vladimir1211/TFG_Volodymyr_Bratasiuk/TMC6140_LA/imagenes/2.png

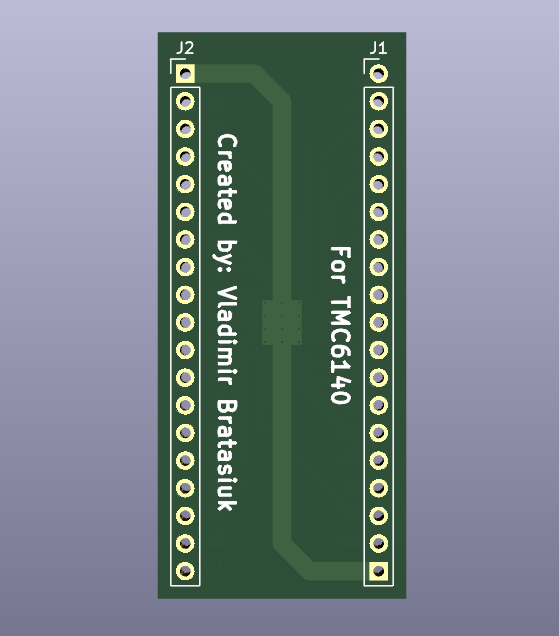
TMC6140_LA/imagenes/2.png
