vladimir1211/TFG_Volodymyr_Bratasiuk/README.md

# TFG_Volodymyr_Bratasiuk
Este repositorio contiene diseños de las PCBs generados para mi TFG durante la segunda mitad del 2022.
