vladimir1211/TFG_Volodymyr_Bratasiuk/BLDC_driver/imagenes/1.png

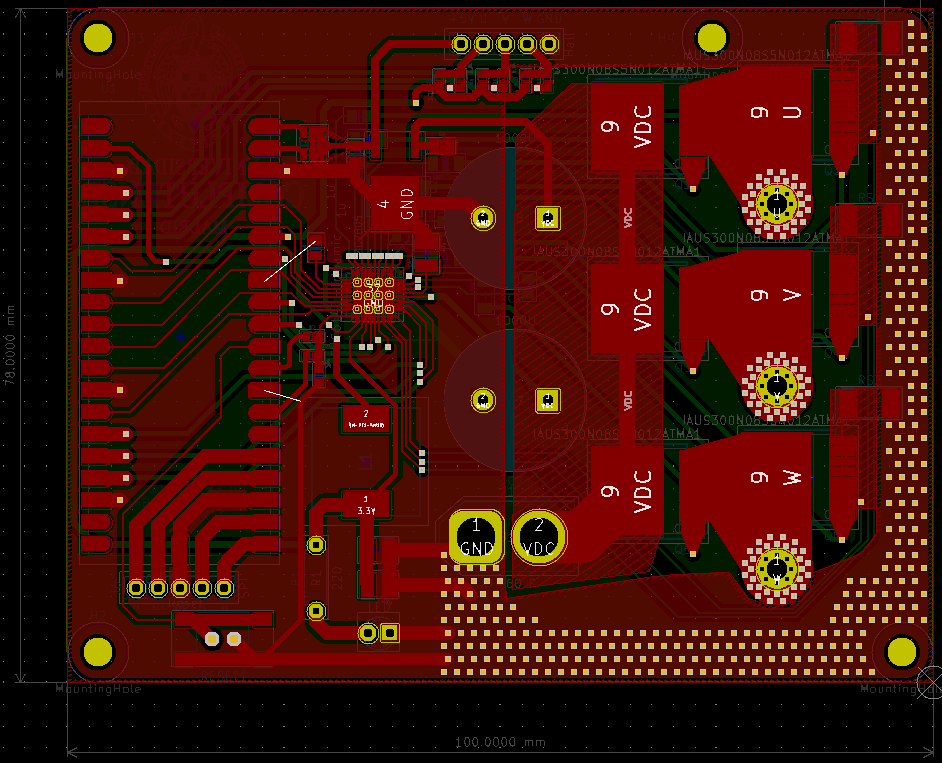
BLDC_driver/imagenes/1.png
