vladimir1211/TFG_Volodymyr_Bratasiuk/BLDC_driver/imagenes/3.png

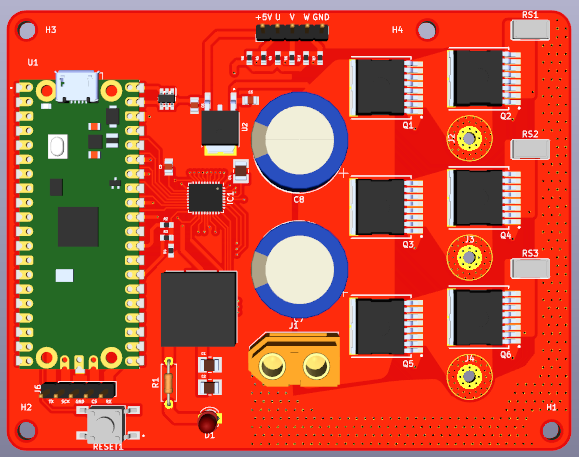
BLDC_driver/imagenes/3.png
