vladimir1211/TFG_Volodymyr_Bratasiuk/BLDC_driver/imagenes/5.jpg

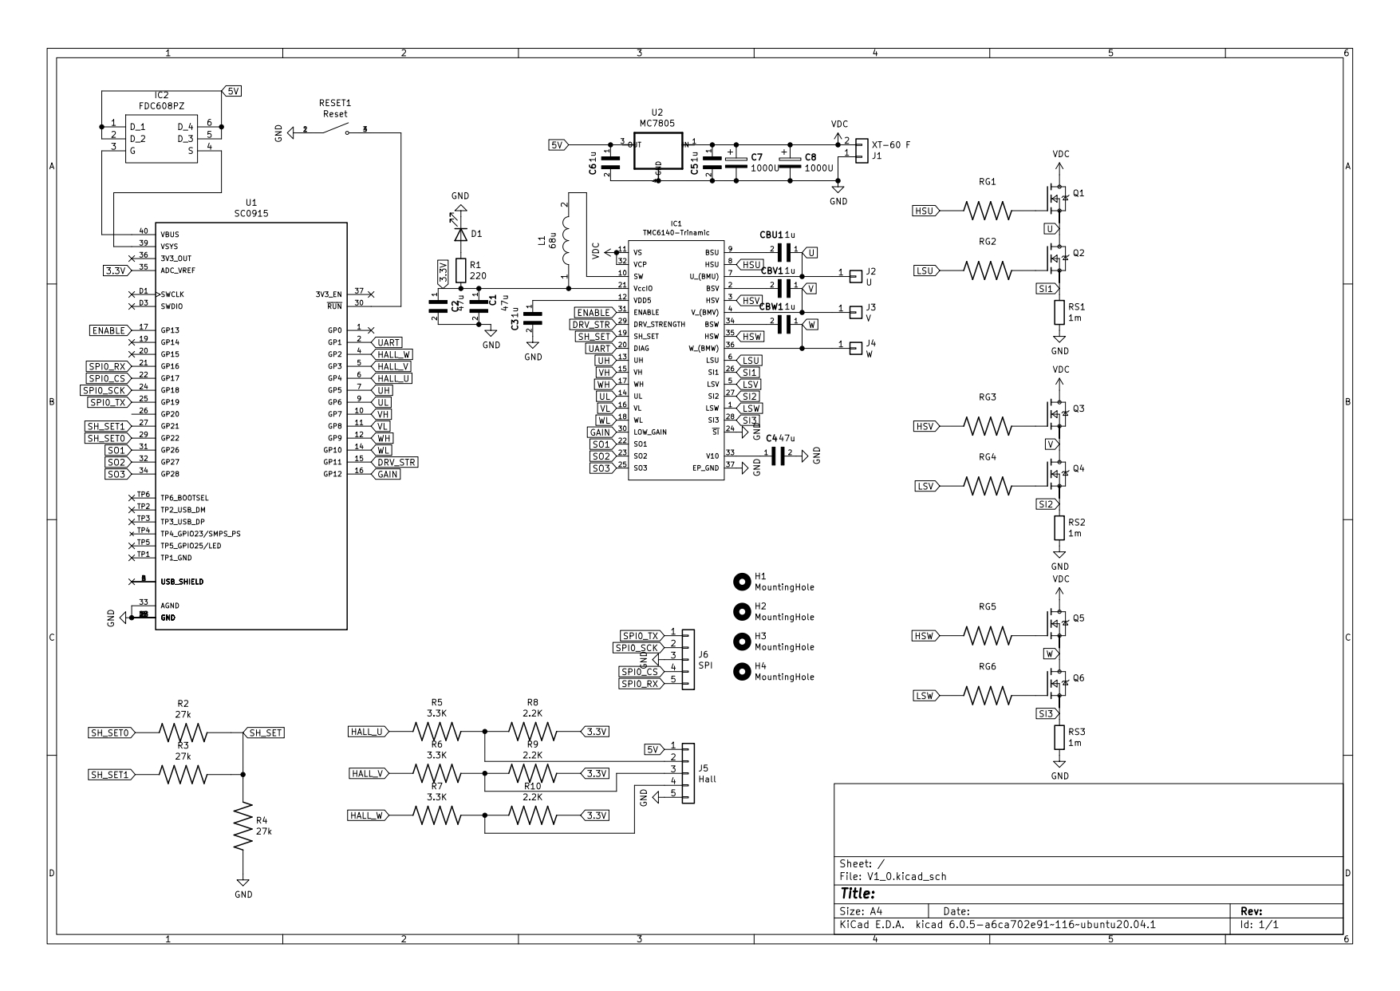
BLDC_driver/imagenes/5.jpg
