vladimir1211/TFG_Volodymyr_Bratasiuk/Sistema_central/imagenes/1.png

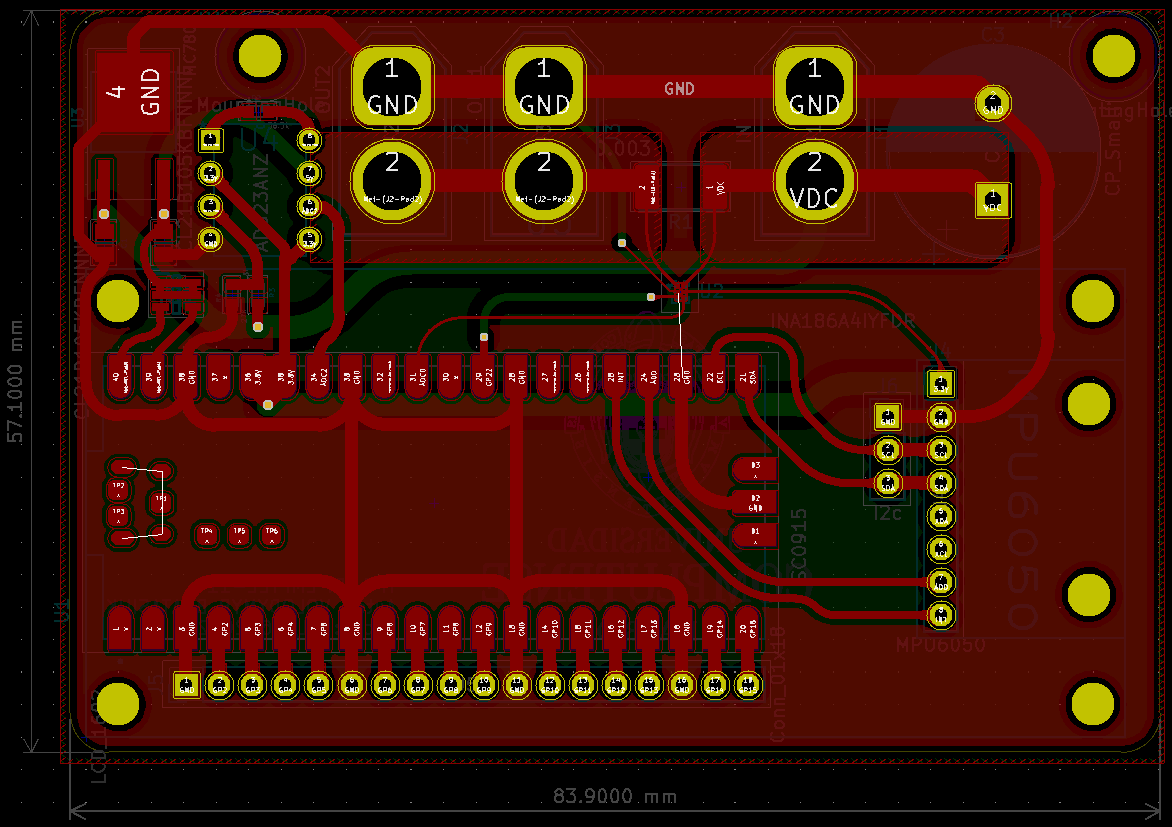
Sistema_central/imagenes/1.png
