vladimir1211/TFG_Volodymyr_Bratasiuk/Sistema_central/imagenes/4.png

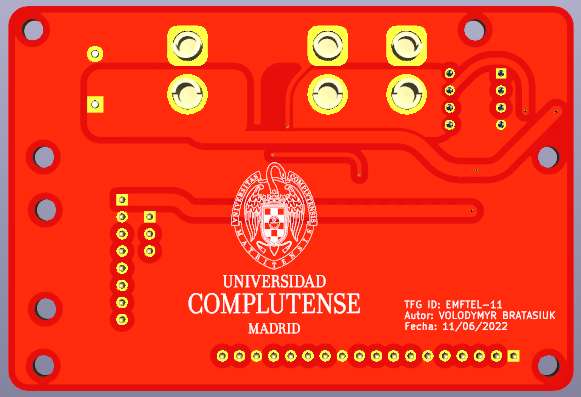
Sistema_central/imagenes/4.png
