vladimir1211/TFG_Volodymyr_Bratasiuk/Sistema_central/imagenes/5.jpg

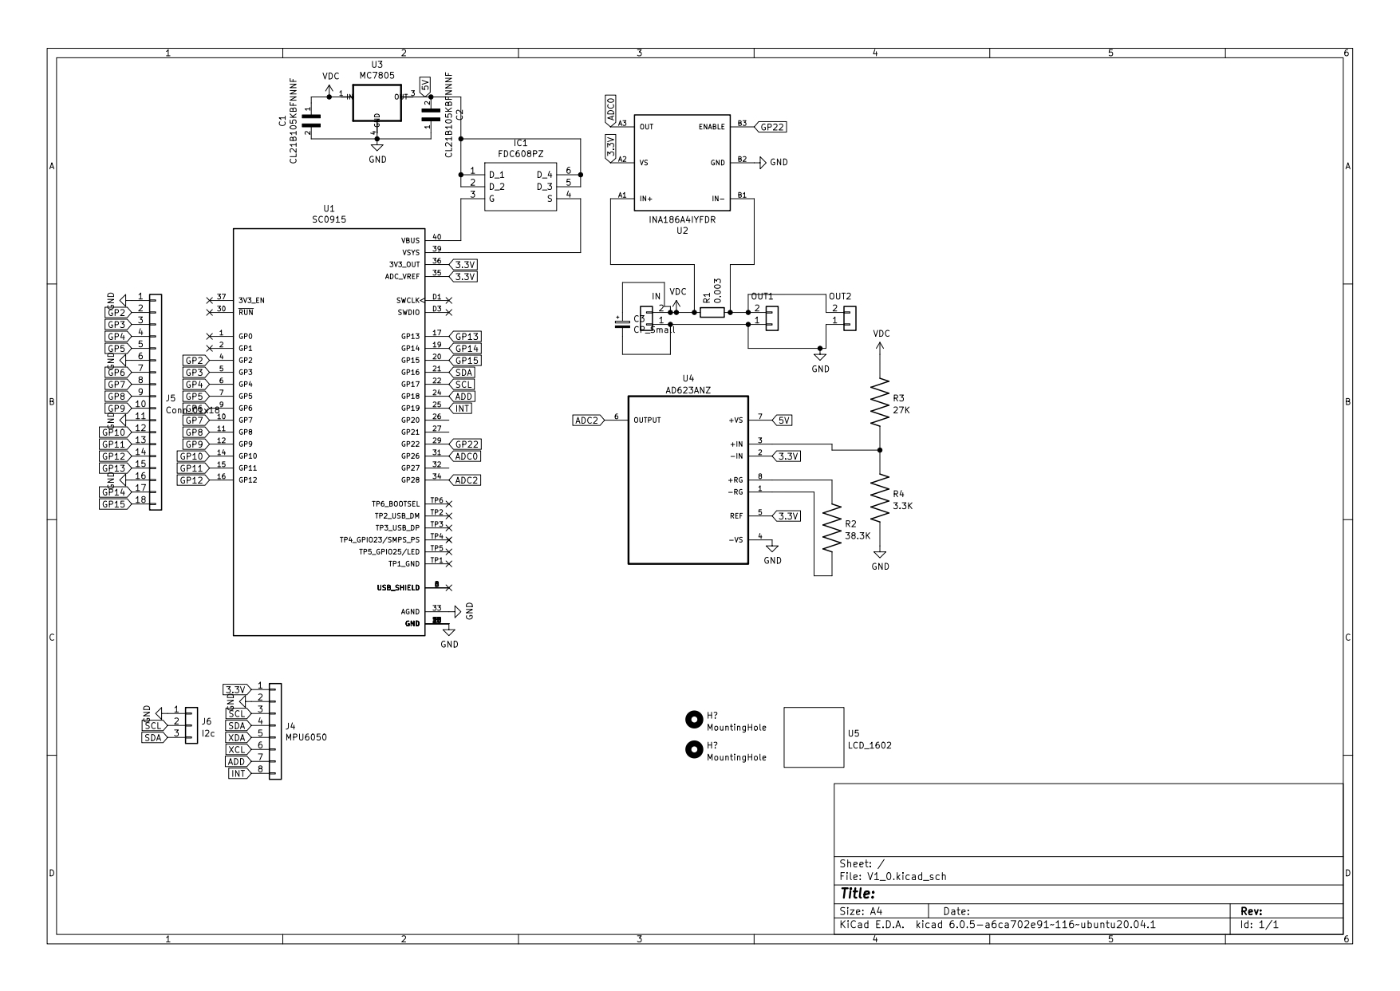
Sistema_central/imagenes/5.jpg
