vladimir1211/TFG_Volodymyr_Bratasiuk/BLDC_driver/BLDC_driver_boom.xlsx

Nº | Referencia | Descripcion | Cantidad | Distribuidor | Enlace de compra | Precio unitario
1 | TMC6140 | Contolador de puertas N-MOS | 3 | Mouser | https://www.mouser.es/ProductDetail/Trinamic/TMC6140-LA-T?qs=QNEnbhJQKvZvnEYkg8LviQ%3D%3D | 3.59
2 | MC7805CDTRKG | Regulador linel de tension 5V-1A | 3 | Mouser | https://www.mouser.es/ProductDetail/onsemi/MC7805CDTRKG?qs=%252B9%2Fcbd0IE0RZ%252B1%252BvH1A5MQ%3D%3D | 0.63
3 | IAUS300N08S5N012 | MOSFET de canal N | 14 | RS | https://es.rs-online.com/web/p/mosfet/2291803 | 3.53
4 | BVT-M-R001 | Resistencia de 1mΩ+-1%, 3W | 10 | RS | https://es.rs-online.com/web/p/resistencias-de-montaje-en-superficie/1930029 | 0.586
5 | Raspberry Pi Pico | Microcontrolador | 3 | RS | https://es.rs-online.com/web/p/raspberry-pi/2122162 | 4.51
6 | 14AWG | Cable rojo y negro (24A) | 1 | Amazon | https://www.amazon.es/Gauge-Silicone-Meters-Flexible-Impedance/dp/B074QR9DT9 | 12.99
7 | XT60 | Conector (60A) | 1 | Amazon | https://www.amazon.es/Conectores-bater%C3%ADa-Battery-Vehicle-Hembra/dp/B074RGT76J (https://www.amazon.es/Conectores-batería-Battery-Vehicle-Hembra/dp/B074RGT76J) | 7.99
8 | Conector | Conector pin PCB | 1 | Amazon | https://www.amazon.es/IZOKEE-Conector-Soldadura-Arduino-Prototype/dp/B07DBY753C | 10.99
9 | RS PRO 741-8880 | Inductancia 2,1A 68uH | 5 | RS | https://es.rs-online.com/web/p/inductores-de-montaje-en-superficie/7418984 | 1.79
10 | CRL1206-FW-1R00ELF | Resistencia de 1Ω+-1%, 0,25W | 20 | RS | https://es.rs-online.com/web/p/resistencias-de-montaje-en-superficie/7944180 | 0.16
11 | CRCW060327K0FKEA | Resistencia de 27KΩ+-1%, 0,1W | 50 | RS | https://es.rs-online.com/web/p/resistencias-de-montaje-en-superficie/6790087 | 0.025
12 | CRG0603F2K2 | Resistencia de 2,2KΩ+-1%, 0,1W | 50 | RS | https://es.rs-online.com/web/p/resistencias-de-montaje-en-superficie/2132317 | 0.043
13 | CR0603-FX-3301ELF | Resistencia de 3,3KΩ+-1%, 0,1W | 50 | RS | https://es.rs-online.com/web/p/resistencias-de-montaje-en-superficie/7408864 | 0.026
14 | FDC608PZ | PMOS | 10 | RS | https://es.rs-online.com/web/p/mosfet/7599037 | 0.537
15 | CL21B105KBFNNNF | Condensador 1uF+-10% 50V | 100 | RS | https://es.rs-online.com/web/p/products/7661062/ | 0.055
16 | GRM32EC81C476KE15L | Condensador 47uF+-10% 16V | 10 | RS | https://es.rs-online.com/web/p/condensadores-ceramicos-multicapa/8467369/ | 0.494
17 | RS PRO 711-1491 | Condensador 1000uF+-20% 50V | 10 | RS | https://es.rs-online.com/web/p/condensadores-de-aluminio/7111491 | 0.879
Total |  |  |  |  |  | 48.825
