vladimir1211/TFG_Volodymyr_Bratasiuk/modelos_kicad/AD623ANZ/AD623ANZ.step

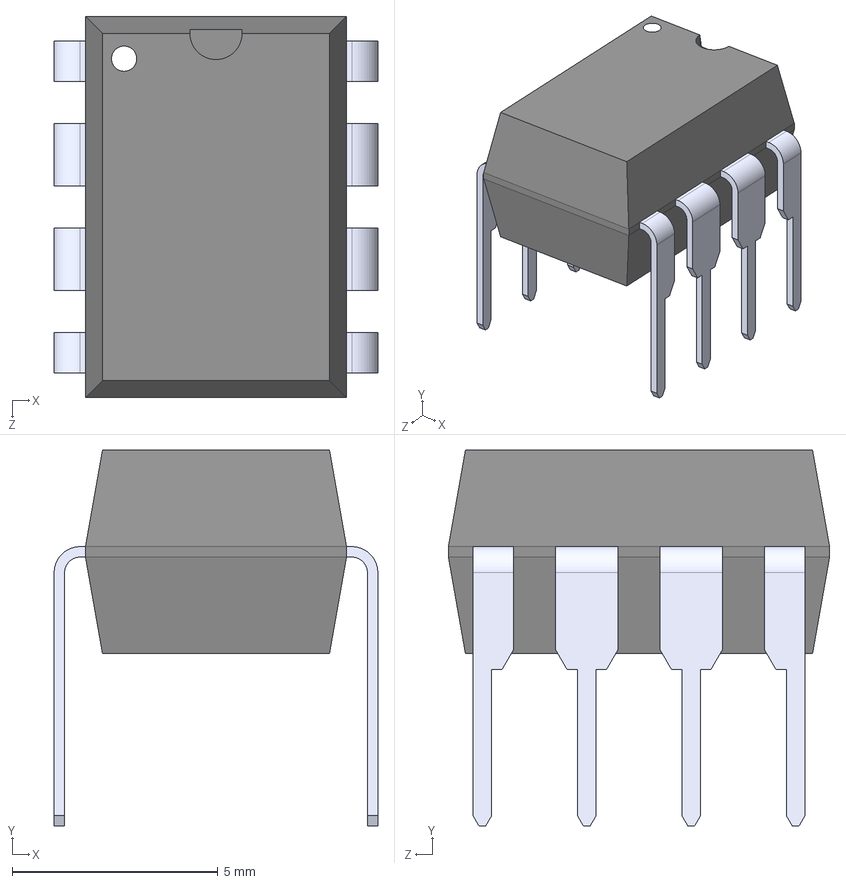
[picture p14: CAD file, 2022-06-18]
modelos_kicad/AD623ANZ/AD623ANZ.step
7.87 x 9.14 x 9.27 mm
