vladimir1211/TFG_Volodymyr_Bratasiuk/modelos_kicad/BVT-M-R001-1.0/2-2176231-7.igs

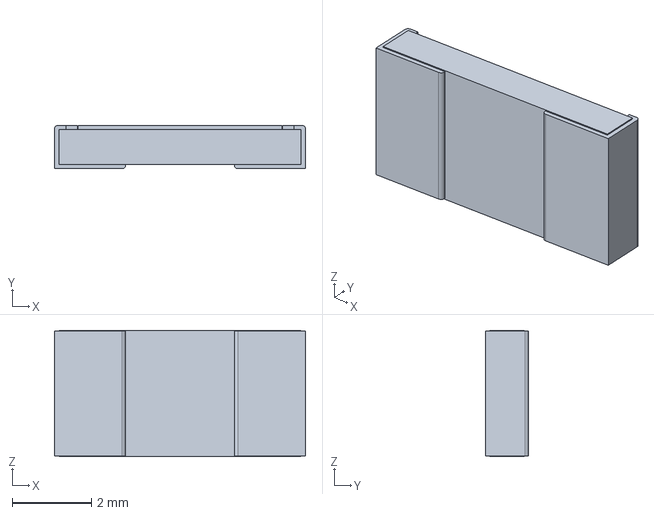
[picture p15: CAD file, 2022-06-18]
modelos_kicad/BVT-M-R001-1.0/2-2176231-7.igs
6.35 x 1.10 x 3.20 mm
