vladimir1211/TFG_Volodymyr_Bratasiuk/modelos_kicad/CL21B105KBFNNNF/CL21B105KBFNNNF.step

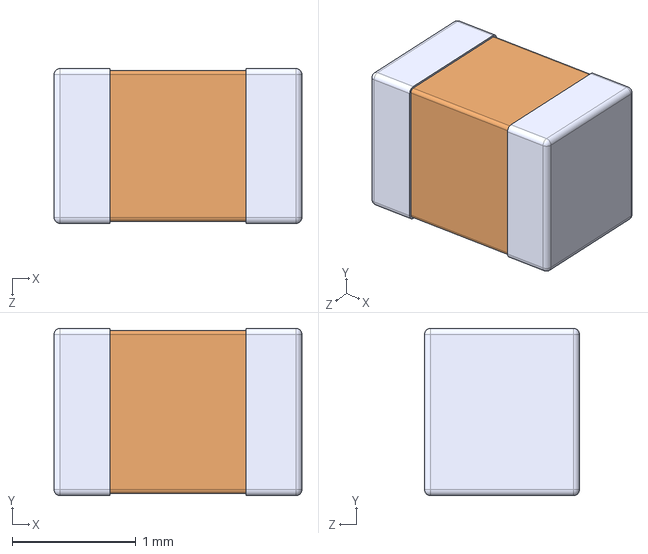
[picture p16: CAD file, 2022-06-18]
modelos_kicad/CL21B105KBFNNNF/CL21B105KBFNNNF.step
2.00 x 1.35 x 1.25 mm
