vladimir1211/TFG_Volodymyr_Bratasiuk/modelos_kicad/CR0603-FX-3301ELF/CR0603-FX-3301ELF.step

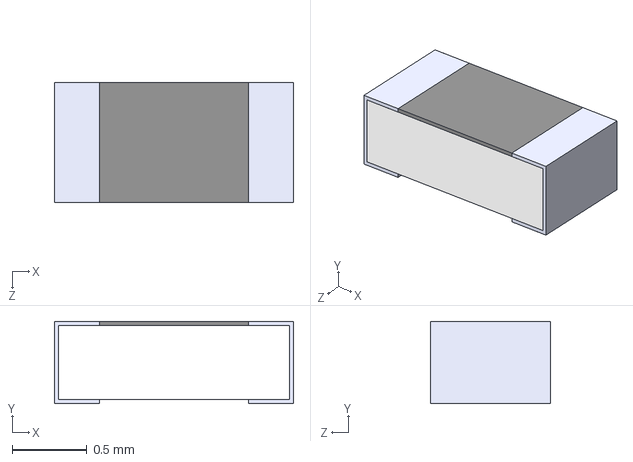
[picture p17: CAD file, 2022-06-18]
modelos_kicad/CR0603-FX-3301ELF/CR0603-FX-3301ELF.step
1.60 x 0.55 x 0.8 mm
