vladimir1211/TFG_Volodymyr_Bratasiuk/modelos_kicad/CRCW060327K0FKEA/CRCW060327K0FKEA.step

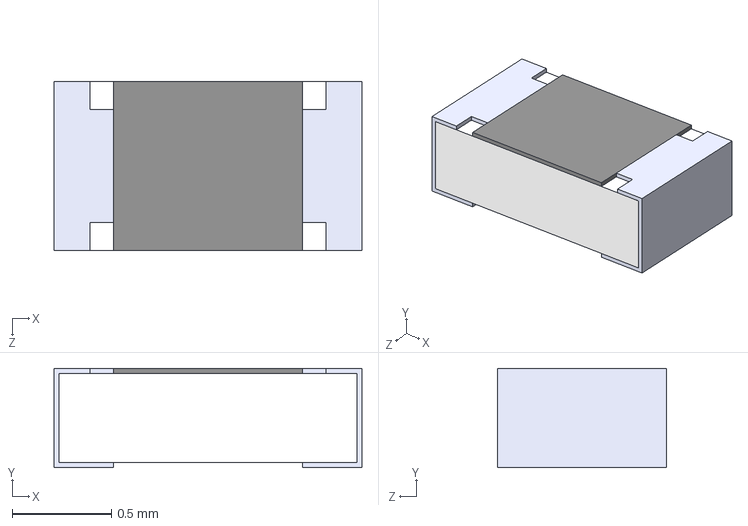
[picture p18: CAD file, 2022-06-18]
modelos_kicad/CRCW060327K0FKEA/CRCW060327K0FKEA.step
1.55 x 0.5 x 0.85 mm
