vladimir1211/TFG_Volodymyr_Bratasiuk/modelos_kicad/CRL1206-FW-1R00ELF/CRL1206-FW-1R00ELF.step

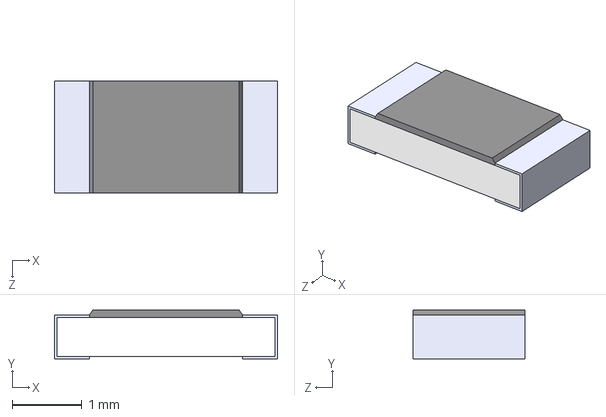
[picture p19: CAD file, 2022-06-18]
modelos_kicad/CRL1206-FW-1R00ELF/CRL1206-FW-1R00ELF.step
3.20 x 0.7 x 1.60 mm
