vladimir1211/TFG_Volodymyr_Bratasiuk/modelos_kicad/FDC608PZ/FDC608PZ.stp

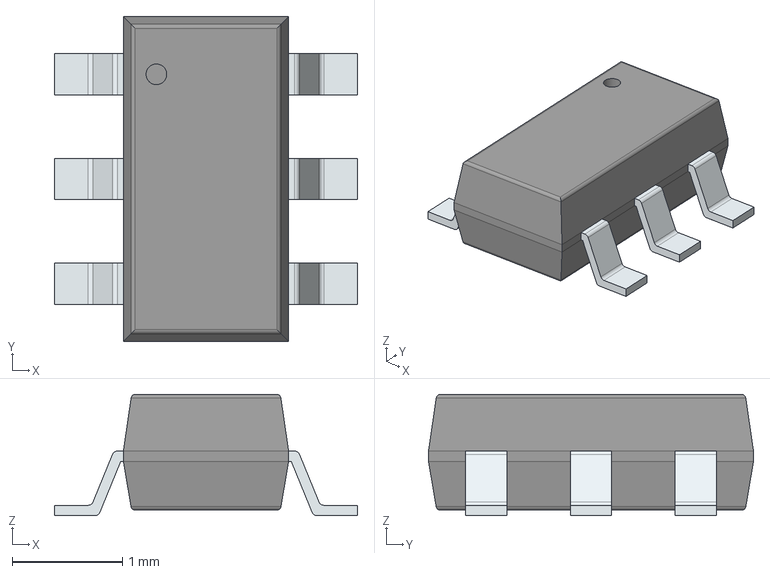
[picture p20: CAD file, 2022-06-18]
modelos_kicad/FDC608PZ/FDC608PZ.stp
2.75 x 2.95 x 1.10 mm
PinsArrayLR
