vladimir1211/TFG_Volodymyr_Bratasiuk/modelos_kicad/GRM32EC81C476KE15L/GRM32EC81C476KE15L.step

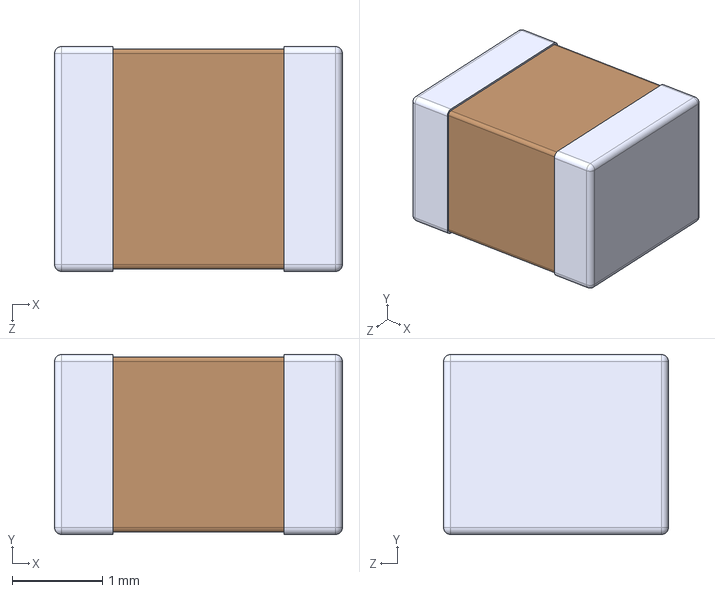
[picture p21: CAD file, 2022-06-18]
modelos_kicad/GRM32EC81C476KE15L/GRM32EC81C476KE15L.step
3.20 x 2.00 x 2.50 mm
