vladimir1211/TFG_Volodymyr_Bratasiuk/modelos_kicad/IAUS300N08S5N012ATMA1/IAUS300N08S5N012ATMA1.step

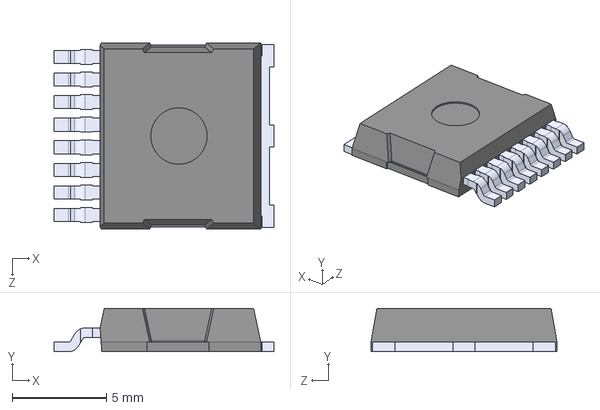
[picture p22: CAD file, 2022-06-18]
modelos_kicad/IAUS300N08S5N012ATMA1/IAUS300N08S5N012ATMA1.step
11.7 x 2.30 x 9.90 mm
