vladimir1211/TFG_Volodymyr_Bratasiuk/modelos_kicad/INA186/INA186A4IYFDR.step

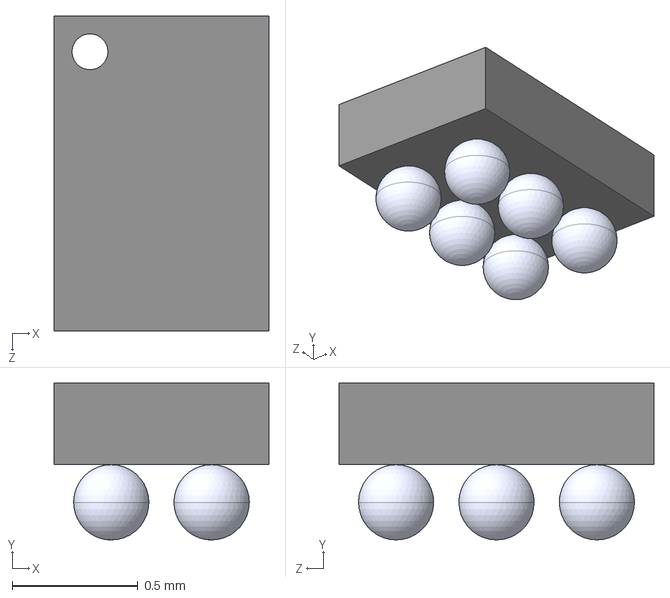
[picture p23: CAD file, 2022-06-18]
modelos_kicad/INA186/INA186A4IYFDR.step
0.855 x 0.625 x 1.26 mm
