vladimir1211/TFG_Volodymyr_Bratasiuk/modelos_kicad/MC7805CDTRKG/TO229P990X238-4N.step

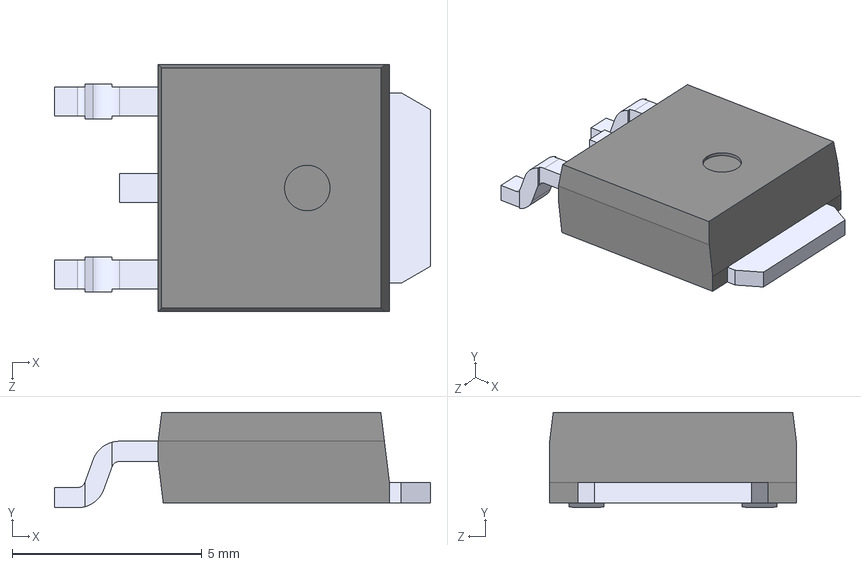
[picture p24: CAD file, 2022-06-18]
modelos_kicad/MC7805CDTRKG/TO229P990X238-4N.step
9.91 x 2.51 x 6.50 mm
