vladimir1211/TFG_Volodymyr_Bratasiuk/modelos_kicad/RP_PICO/SC0915.step

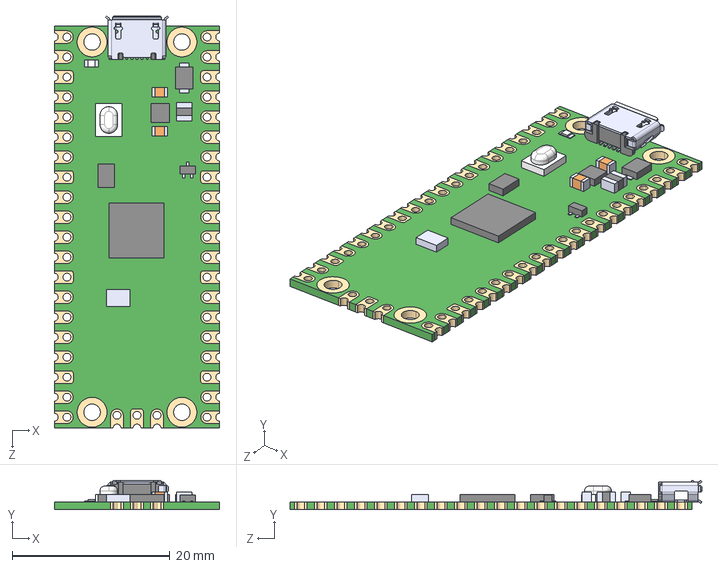
[picture p26: CAD file, 2022-06-18]
modelos_kicad/RP_PICO/SC0915.step
21.0 x 3.73 x 52.3 mm
