vladimir1211/TFG_Volodymyr_Bratasiuk/modelos_kicad/button/1571563-1.step

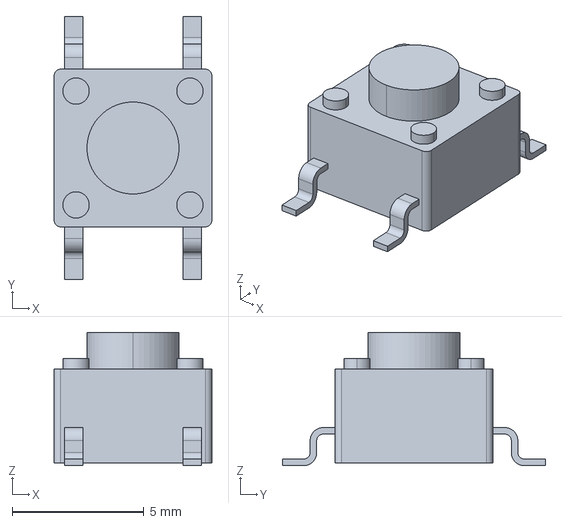
[picture p27: CAD file, 2022-06-18]
modelos_kicad/button/1571563-1.step
6.00 x 10.0 x 5.07 mm
