vladimir1211/TFG_Volodymyr_Bratasiuk/(list of files, cad)

Other CAD files:
modelos_kicad/CRG0603F2K2/CRG0603F2K2.step
