vladimir1211/TFG_Volodymyr_Bratasiuk/BLDC_driver/imagenes/V1_0.pdf

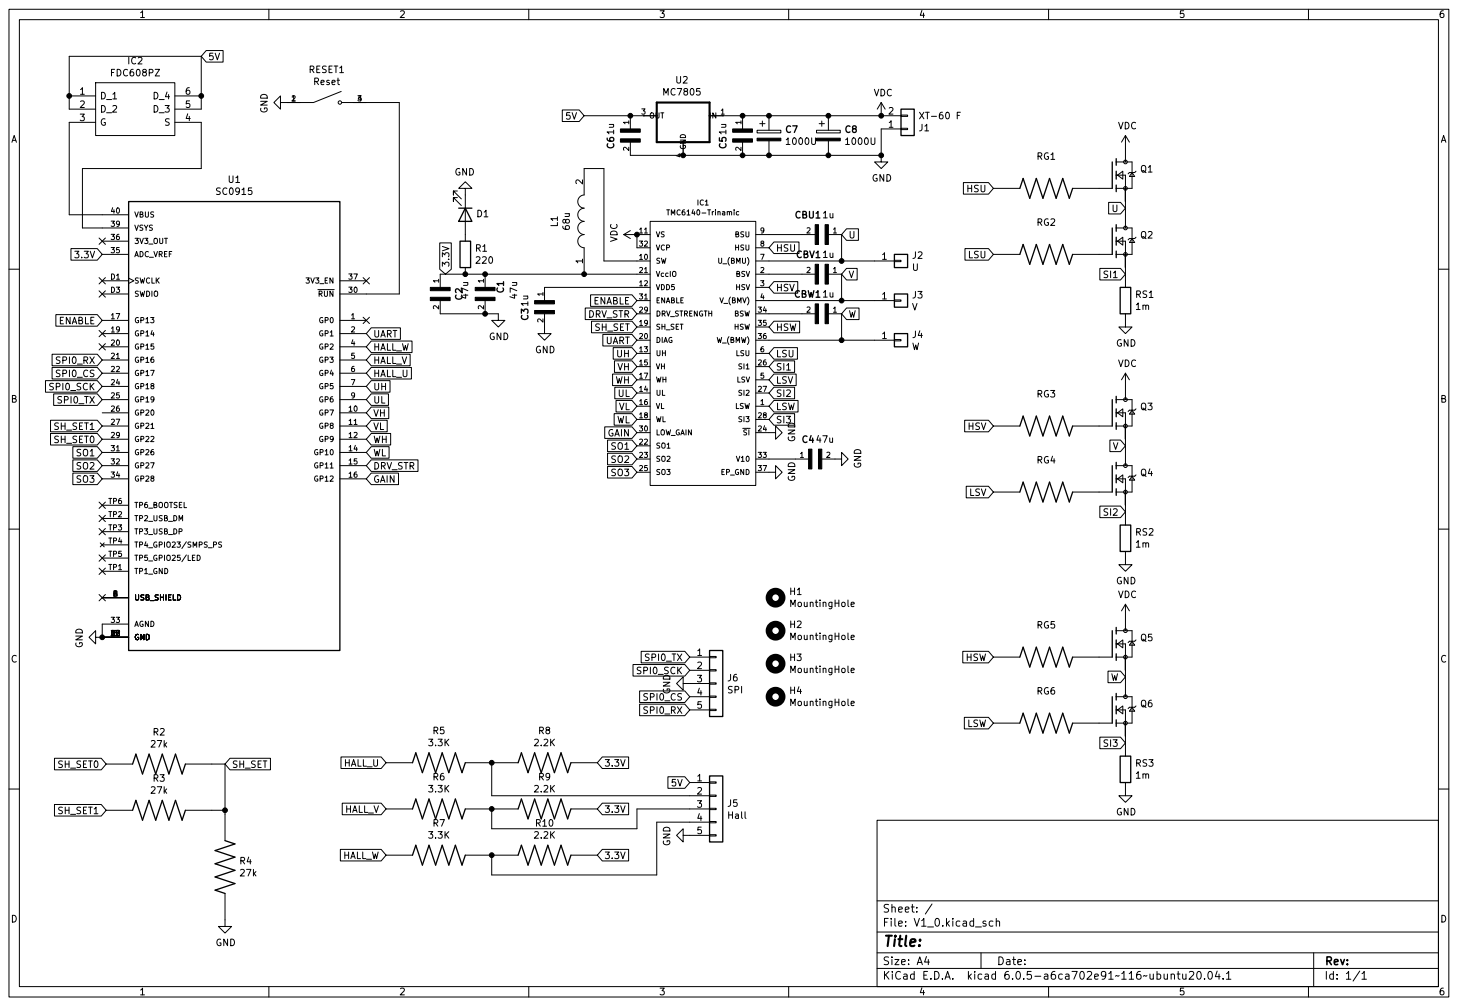
[picture p28: page 1]
