vladimir1211/TFG_Volodymyr_Bratasiuk/Sistema_central/imagenes/V1_0.pdf

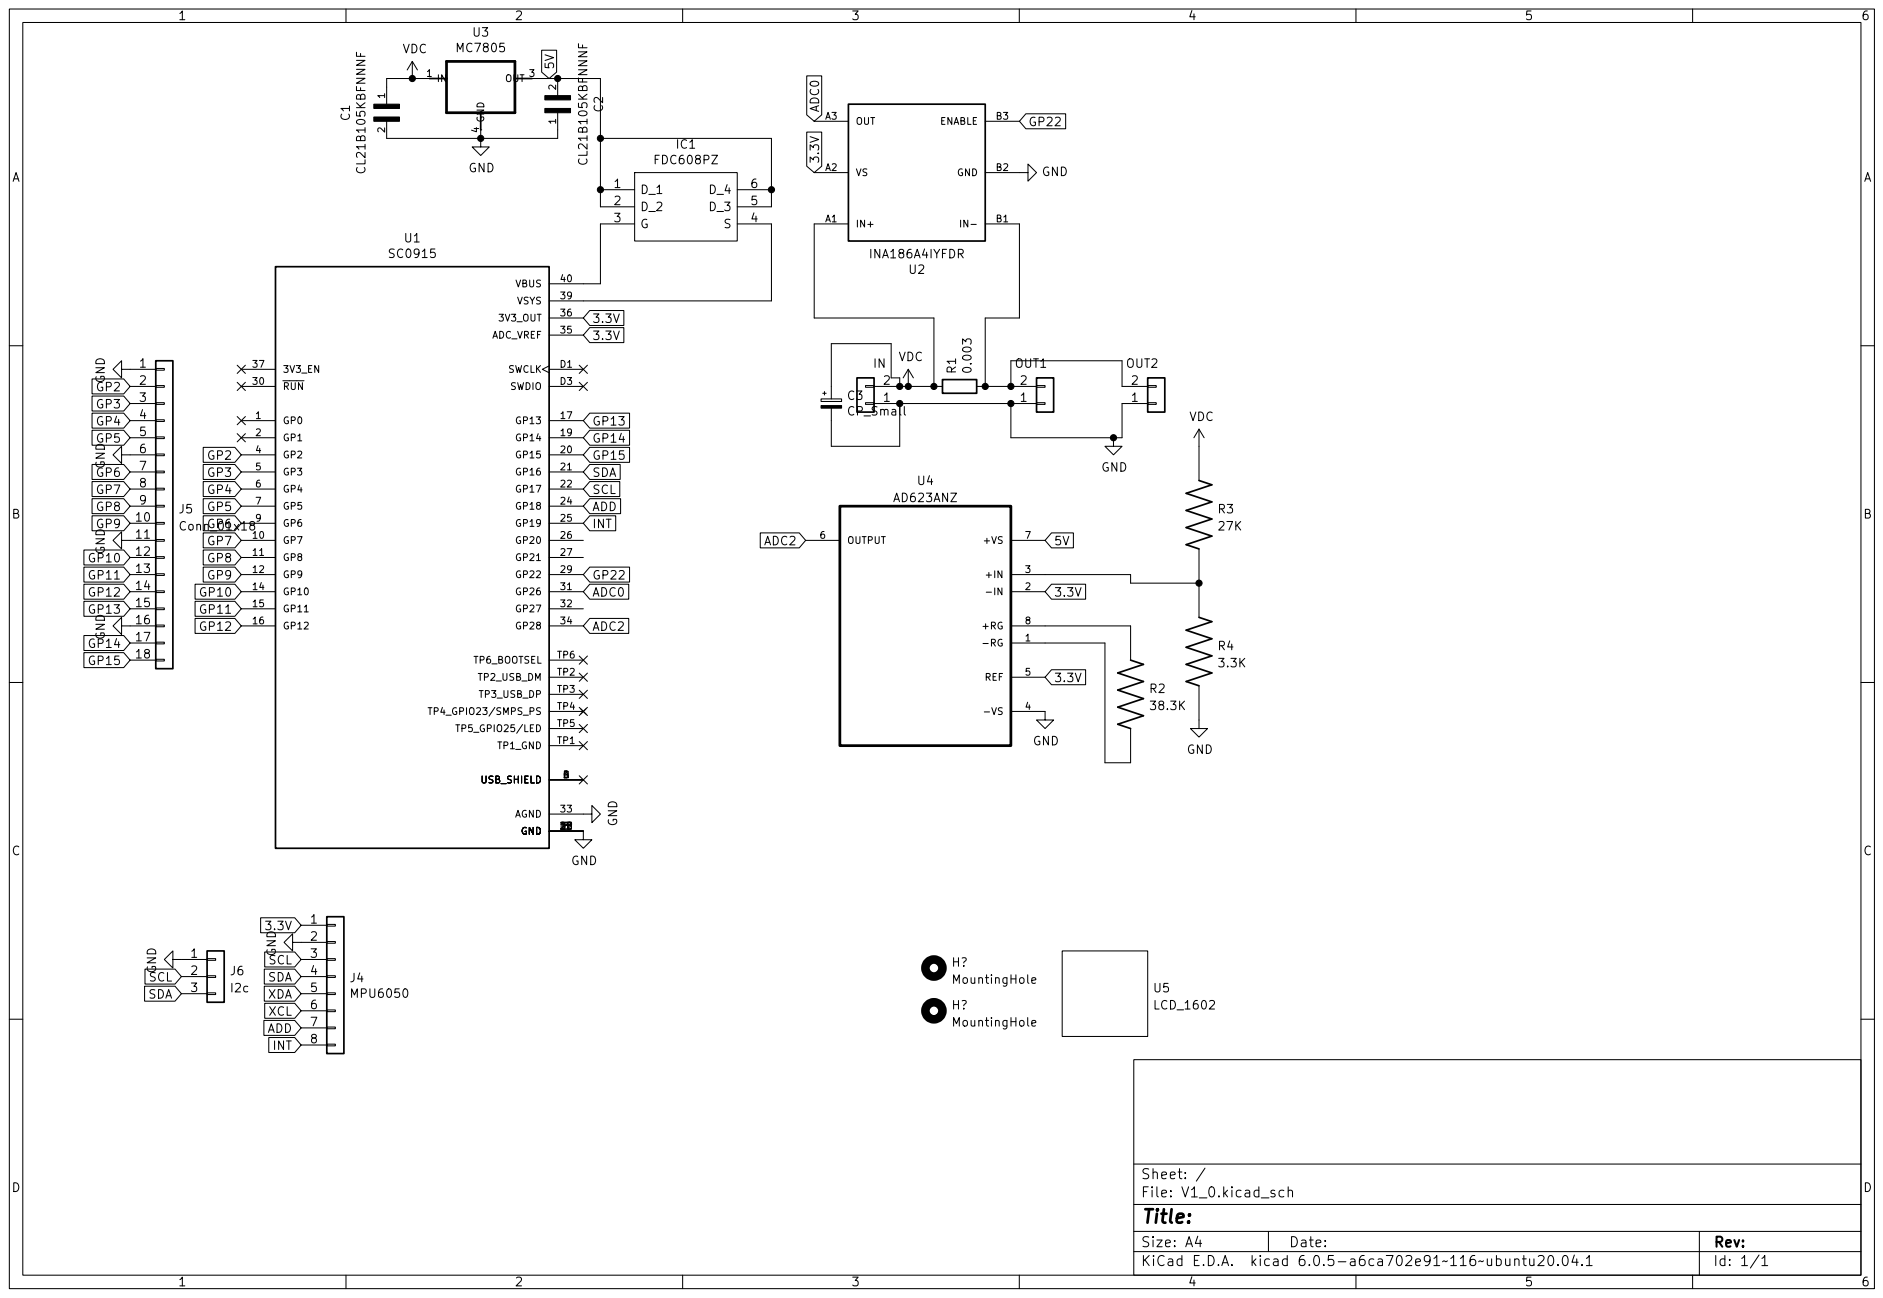
[picture p29: page 1]
