vladimir1211/TFG_Volodymyr_Bratasiuk/(list of files, drawings)

Other design files:
BLDC_driver/KiCad/V1_0.dsn
TMC6140_LA/KiCad/controlador.dsn
