vladimir1211/TFG_Volodymyr_Bratasiuk/BLDC_driver/KiCad/V1_0.kicad_pcb

## KiCad design BLDC_driver/KiCad/V1_0.kicad_pcb (2022-06-18)

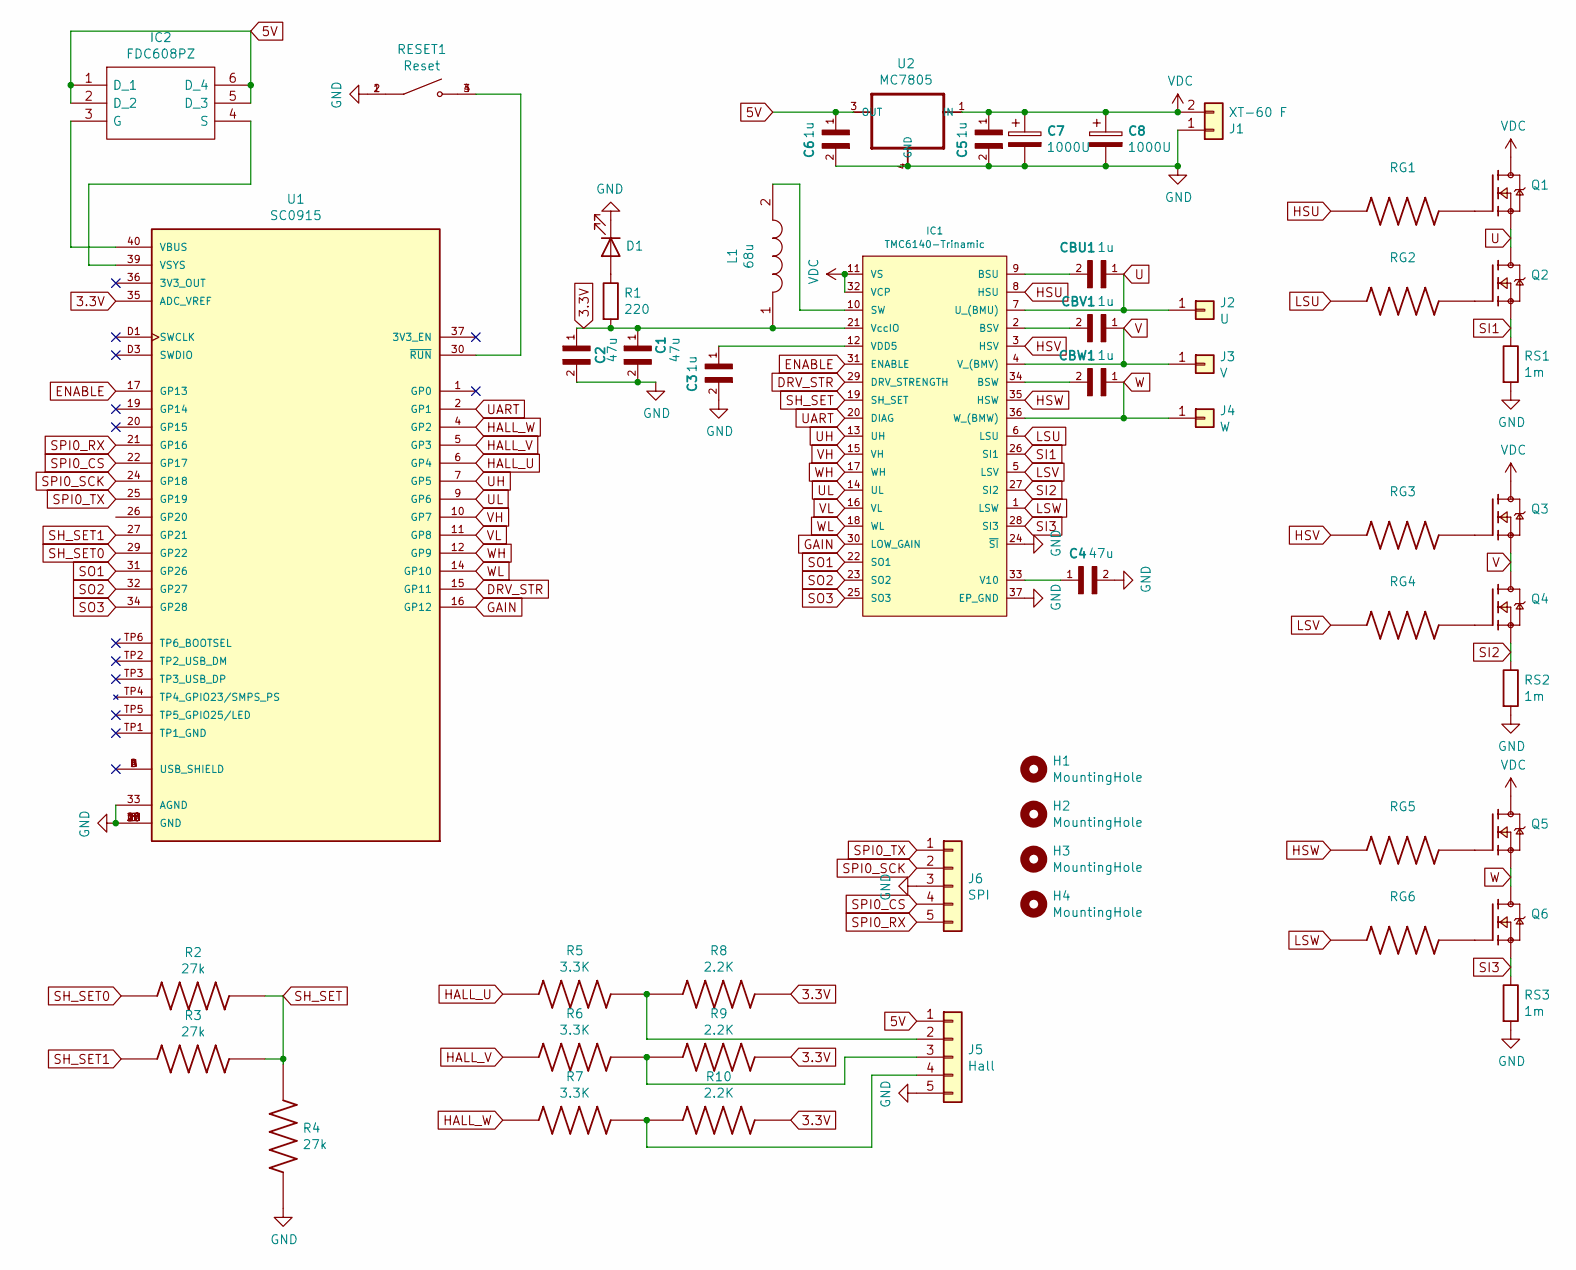
[picture p30: schematic V1_0.kicad_sch]

Parts:
C1, C2, C4: 47u; CAPC3225X270N
C3, C5, C6: 1u; CAPC2012X140N
C7, C8: 1000U; CP_Radial_D16.0mm_P7.50mm
CBU1: 1u; CAPC2012X140N
CBV1: 1u; CAPC2012X140N
CBW1: 1u; CAPC2012X140N
D1: LED; LED_D3.0mm
H1, H2, H3, H4: MountingHole; MountingHole_3.2mm_M3
IC1: TMC6140-Trinamic; QFN-36-1EP_5x6mm_P0.5mm_EP3.6x4.1mm_ThermalVias
IC2: FDC608PZ; SOT95P275X110-6N; Manufacturer_Part_Number FDC608PZ
J1: XT-60 F; AMASS_XT60-F_1x02_P7.20mm_Vertical
J2: U; MountingHole_2.2mm_M2_Pad_Via
J3: V; MountingHole_2.2mm_M2_Pad_Via
J4: W; MountingHole_2.2mm_M2_Pad_Via
J5: Hall; PinHeader_1x05_P2.54mm_Vertical
J6: SPI; PinHeader_1x05_P2.54mm_Vertical
L1: 68u; NPIS27H680MTRF; Manufacturer_Part_Number NPIS27H680MTRF
Q1, Q2, Q3, Q4, Q5, Q6: IAUS300N08S5N012ATMA1; IFX-PG-HSOG-8-1-V; PARTREV 1.0
R1: 220; R_Axial_DIN0207_L6.3mm_D2.5mm_P7.62mm_Horizontal
R2, R3, R4: 27k; RESC1508X50N
R5, R6, R7: 3.3K; RESC1608X55N
R8, R9, R10: 2.2K; RESC1608X55N; Voltage_Rating 50 V; Tolerance 1%
RESET1: Reset; SW_1571563-1
RG1, RG2, RG3, RG4, RG5, RG6: CRL1206-FW-1R00ELF; RESC3216X70N
RS1, RS2, RS3: 1m; RESC6331X70N
U1: SC0915; MODULE_SC0915; PARTREV 1.6
U2: MC7805; TO229P990X238-4N

Connections:
3.3V: C1.1, C2.1, IC1.21 (VccIO), L1.1, R1.2, R8.2, R9.2, R10.2, U1.35 (ADC_VREF)
5V: C6.1, IC2.1 (D_1), IC2.2 (D_2), IC2.5 (D_3), IC2.6 (D_4), J5.1, U2.3 (OUT)
DRV_STR: IC1.29 (DRV_STRENGTH), U1.15 (GP11)
ENABLE: IC1.31 (ENABLE), U1.17 (GP13)
GAIN: IC1.30 (LOW_GAIN), U1.16 (GP12)
GND: C1.2, C2.2, C3.2, C4.2, C5.2, C6.2, C7.2, C8.2, D1.1 (K), IC1.24 (~SI), IC1.37 (EP_GND), J1.1, J5.5, J6.3, R4.1, RESET1.1, RESET1.2, RS1.2, RS2.2, RS3.2, U1.3 (GND), U1.8 (GND), U1.13 (GND), U1.18 (GND), U1.23 (GND), U1.28 (GND), U1.33 (AGND), U1.38 (GND), U1.D2 (GND), U2.4 (GND)
HALL_U: R5.1, U1.6 (GP4)
HALL_V: R6.1, U1.5 (GP3)
HALL_W: R7.1, U1.4 (GP2)
HSU: IC1.8 (HSU), RG1.1
HSV: IC1.3 (HSV), RG3.1
HSW: IC1.35 (HSW), RG5.1
LSU: IC1.6 (LSU), RG2.1
LSV: IC1.5 (LSV), RG4.1
LSW: IC1.1 (LSW), RG6.1
unnamed: C3.1, IC1.12 (VDD5)
unnamed: C4.1, IC1.33 (V10)
unnamed: CBU1.2, IC1.9 (BSU)
unnamed: CBV1.2, IC1.2 (BSV)
unnamed: CBW1.2, IC1.34 (BSW)
unnamed: D1.2 (A), R1.1
unnamed: IC1.10 (SW), L1.2
unnamed: IC2.3 (G), U1.40 (VBUS)
unnamed: IC2.4 (S), U1.39 (VSYS)
unnamed: J5.2, R5.2, R8.1
unnamed: J5.3, R6.2, R9.1
unnamed: J5.4, R7.2, R10.1
unnamed: Q1.1, RG1.2
unnamed: Q2.1, RG2.2
unnamed: Q3.1, RG3.2
unnamed: Q4.1, RG4.2
unnamed: Q5.1, RG5.2
unnamed: Q6.1, RG6.2
unnamed: RESET1.3, RESET1.4, U1.30 (~RUN)
SH_SET: IC1.19 (SH_SET), R2.2, R3.2, R4.2
SH_SET0: R2.1, U1.29 (GP22)
SH_SET1: R3.1, U1.27 (GP21)
SI1: IC1.26 (SI1), Q2.2, Q2.3, Q2.4, Q2.5, Q2.6, Q2.7, Q2.8, RS1.1
SI2: IC1.27 (SI2), Q4.2, Q4.3, Q4.4, Q4.5, Q4.6, Q4.7, Q4.8, RS2.1
SI3: IC1.28 (SI3), Q6.2, Q6.3, Q6.4, Q6.5, Q6.6, Q6.7, Q6.8, RS3.1
SO1: IC1.22 (SO1), U1.31 (GP26)
SO2: IC1.23 (SO2), U1.32 (GP27)
SO3: IC1.25 (SO3), U1.34 (GP28)
SPI0_CS: J6.4, U1.22 (GP17)
SPI0_RX: J6.5, U1.21 (GP16)
SPI0_SCK: J6.2, U1.24 (GP18)
SPI0_TX: J6.1, U1.25 (GP19)
U: CBU1.1, IC1.7 (U_(BMU)), J2.1, Q1.2, Q1.3, Q1.4, Q1.5, Q1.6, Q1.7, Q1.8, Q2.9
UART: IC1.20 (DIAG), U1.2 (GP1)
UH: IC1.13 (UH), U1.7 (GP5)
UL: IC1.14 (UL), U1.9 (GP6)
V: CBV1.1, IC1.4 (V_(BMV)), J3.1, Q3.2, Q3.3, Q3.4, Q3.5, Q3.6, Q3.7, Q3.8, Q4.9
VDC: C5.1, C7.1, C8.1, IC1.11 (VS), IC1.32 (VCP), J1.2, Q1.9, Q3.9, Q5.9, U2.1 (IN)
VH: IC1.15 (VH), U1.10 (GP7)
VL: IC1.16 (VL), U1.11 (GP8)
W: CBW1.1, IC1.36 (W_(BMW)), J4.1, Q5.2, Q5.3, Q5.4, Q5.5, Q5.6, Q5.7, Q5.8, Q6.9
WH: IC1.17 (WH), U1.12 (GP9)
WL: IC1.18 (WL), U1.14 (GP10)

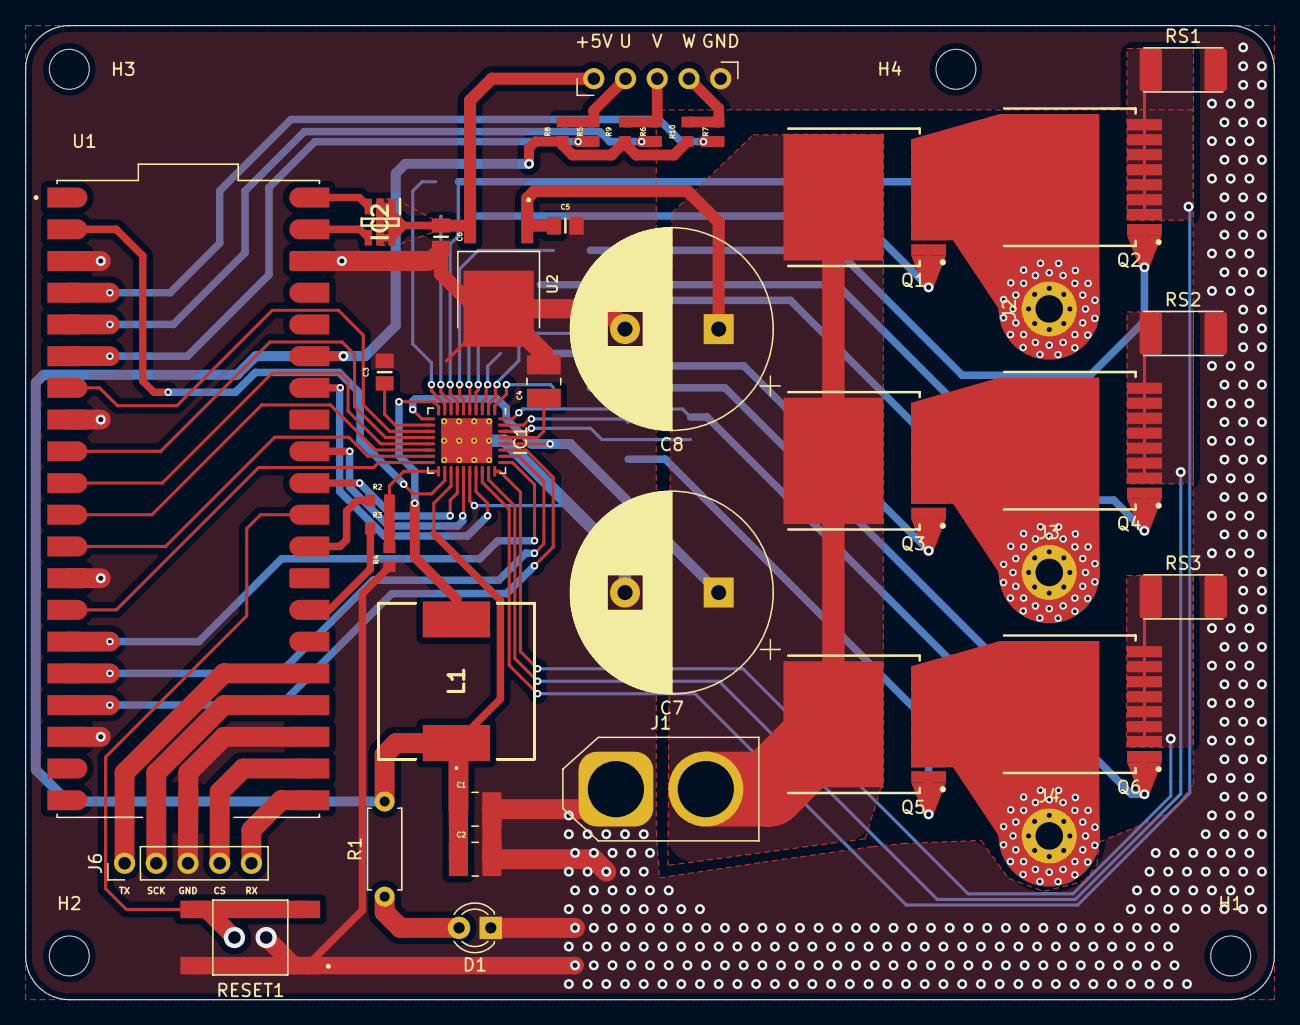
[picture p31: board V1_0.kicad_pcb from above]

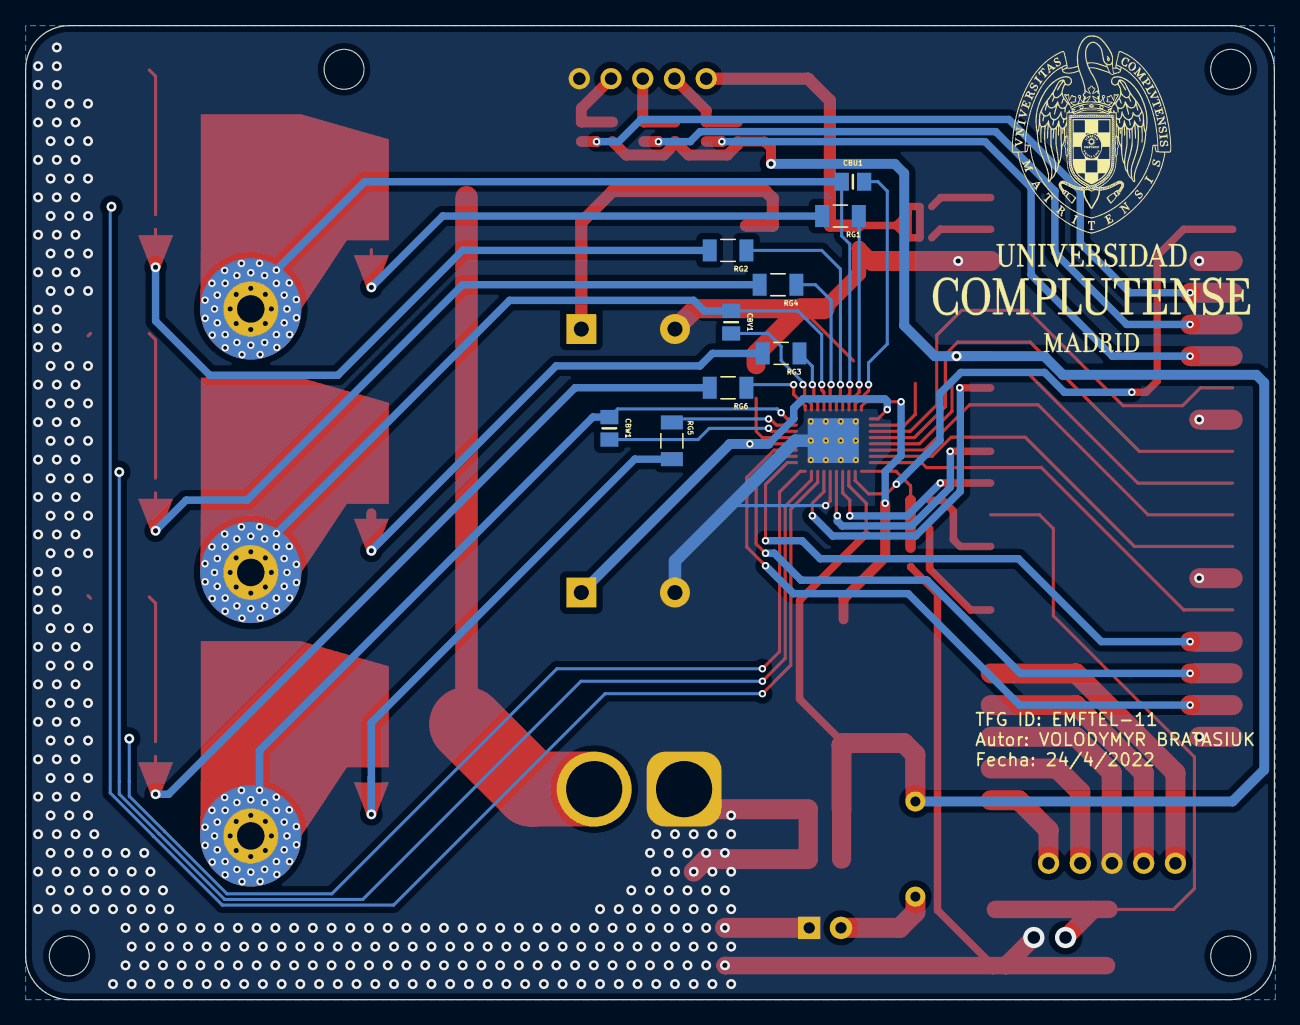
[picture p32: board V1_0.kicad_pcb from below]

Board: 2 copper layers, 100.0 x 78.0 mm, 53 parts (9 on the bottom side), 58 nets.
