vladimir1211/TFG_Volodymyr_Bratasiuk/TMC6140_LA/KiCad/controlador.kicad_pcb

## KiCad design TMC6140_LA/KiCad/controlador.kicad_pcb (2022-06-18)

Schematic: controlador.sch

Parts:
IC1: TMC6140-Trinamic; QFN-36-1EP_5x6mm_P0.5mm_EP3.6x4.1mm_ThermalVias
J1, J2: Conn_01x19; PinHeader_1x19_P2.54mm_Vertical

Connections:
1: IC1.1, J1.1
2: IC1.2, J1.2
3: IC1.3, J1.3
4: IC1.4, J1.4
5: IC1.5, J1.5
6: IC1.6, J1.6
7: IC1.7, J1.7
8: IC1.8, J1.8
9: IC1.9, J1.9
10: IC1.10, J1.10
11: IC1.11, J1.11
12: IC1.12, J1.12
13: IC1.13, J1.13
14: IC1.14, J1.14
15: IC1.15, J1.15
16: IC1.16, J1.16
17: IC1.17, J1.17
18: IC1.18, J1.18
19: IC1.19, J2.19
20: IC1.20, J2.18
21: IC1.21, J2.17
22: IC1.22, J2.16
23: IC1.23, J2.15
24: IC1.24, J2.14
25: IC1.25, J2.13
26: IC1.26, J2.12
27: IC1.27, J2.11
28: IC1.28, J2.10
29: IC1.29, J2.9
30: IC1.30, J2.8
31: IC1.31, J2.7
32: IC1.32, J2.6
33: IC1.33, J2.5
34: IC1.34, J2.4
35: IC1.35, J2.3
36: IC1.36, J2.2
GND: IC1.37, J1.19, J2.1

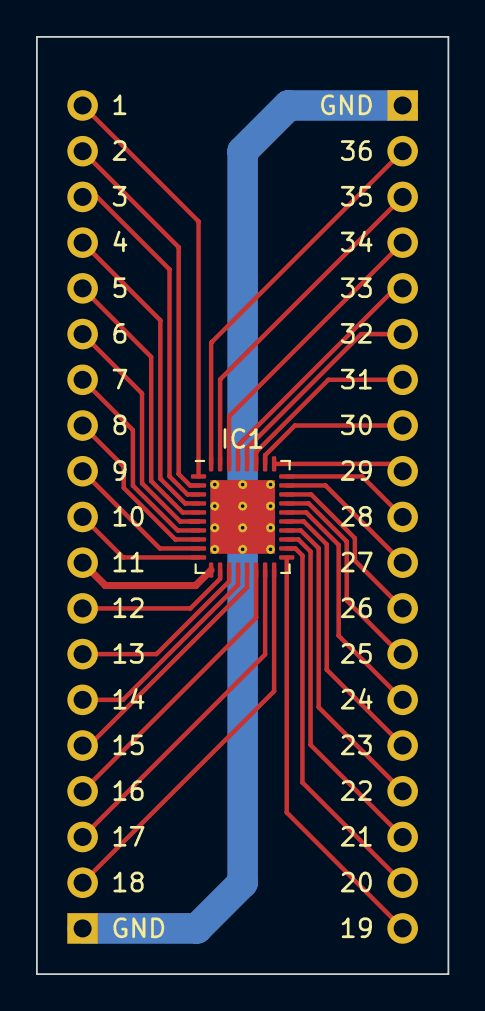
[picture p33: board controlador.kicad_pcb from above]

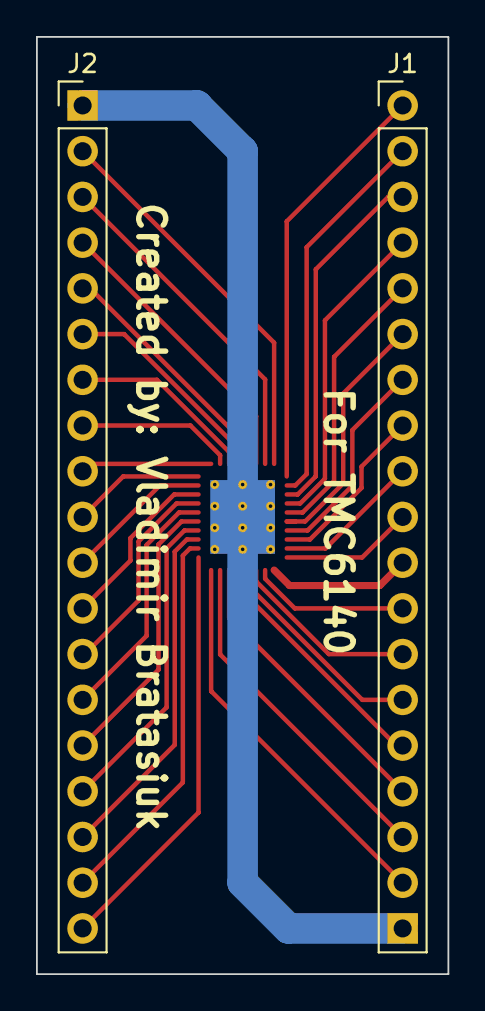
[picture p34: board controlador.kicad_pcb from below]

Board: 2 copper layers, 22.9 x 52.1 mm, 3 parts (2 on the bottom side), 37 nets.
