vladimir1211/TFG_Volodymyr_Bratasiuk/(notices)

Notices in the files:
modelos_kicad/BVT-M-R001-1.0/2-2176231-7.igs:
3D InterOp IGES (v. 2020 1.0.1), Spatial Corp. Copyright (c) 1999-2017. S 1
